adp1030/VLSI_Sine_Gen/report/dac_layout.png

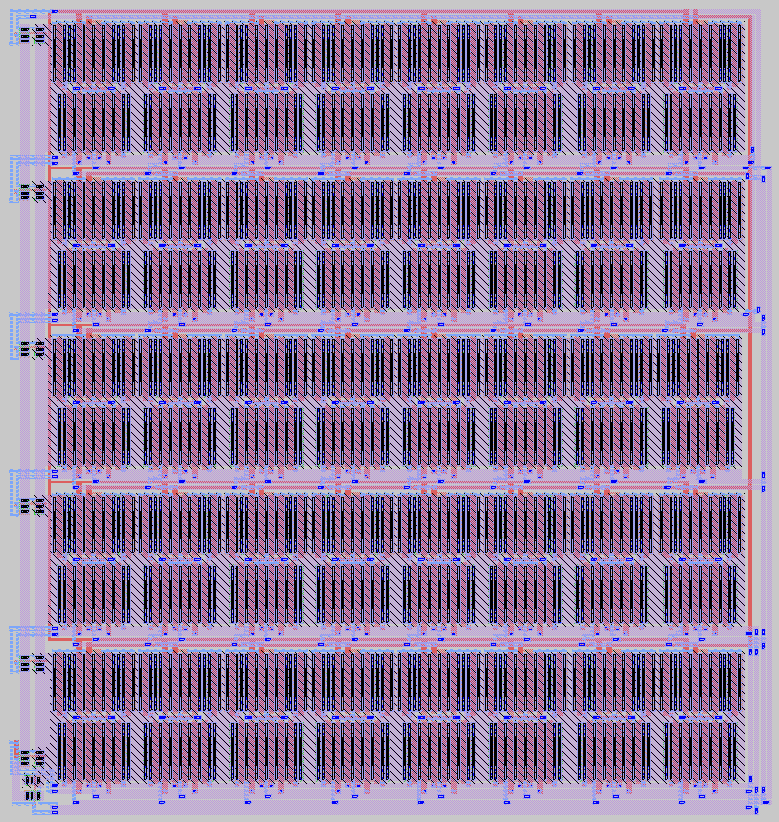
report/dac_layout.png
