adp1030/VLSI_Sine_Gen/report/dac_unit_layout.png

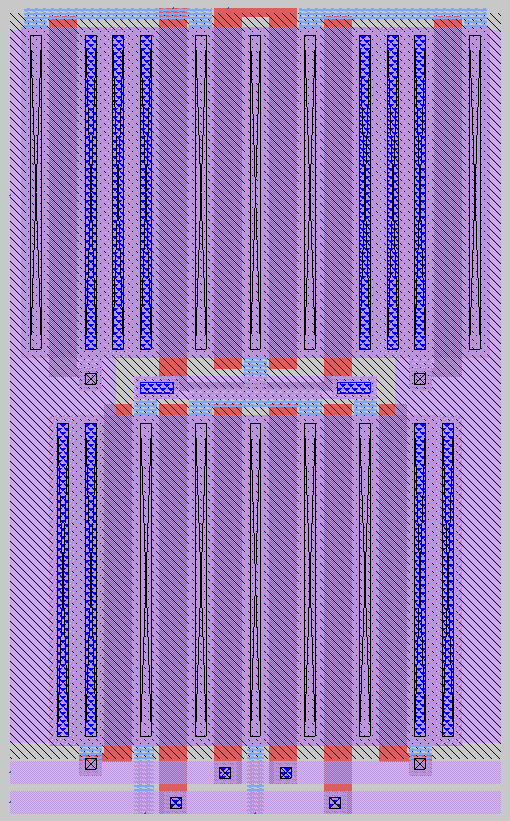
report/dac_unit_layout.png
