adp1030/VLSI_Sine_Gen/report/dac_unit_xschem.png

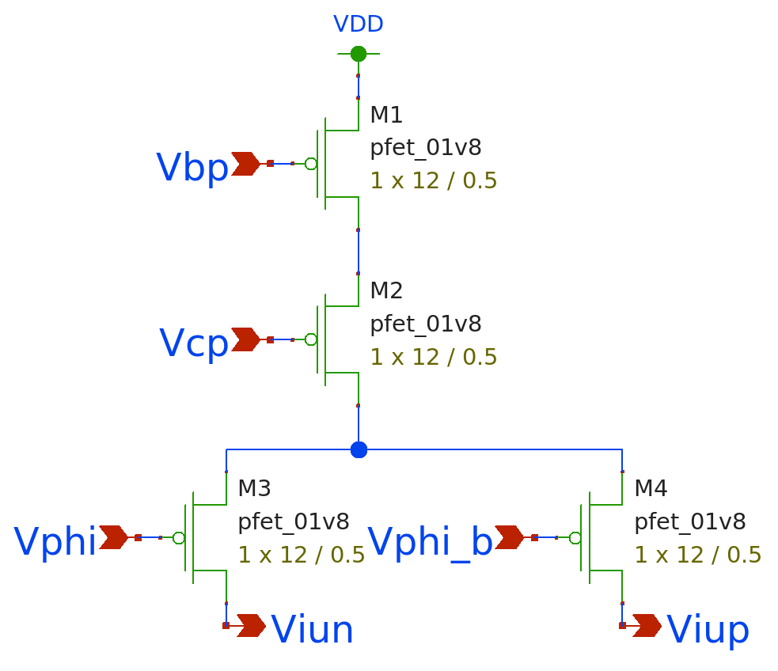
report/dac_unit_xschem.png
