adp1030/VLSI_Sine_Gen/report/dac_xschem.png

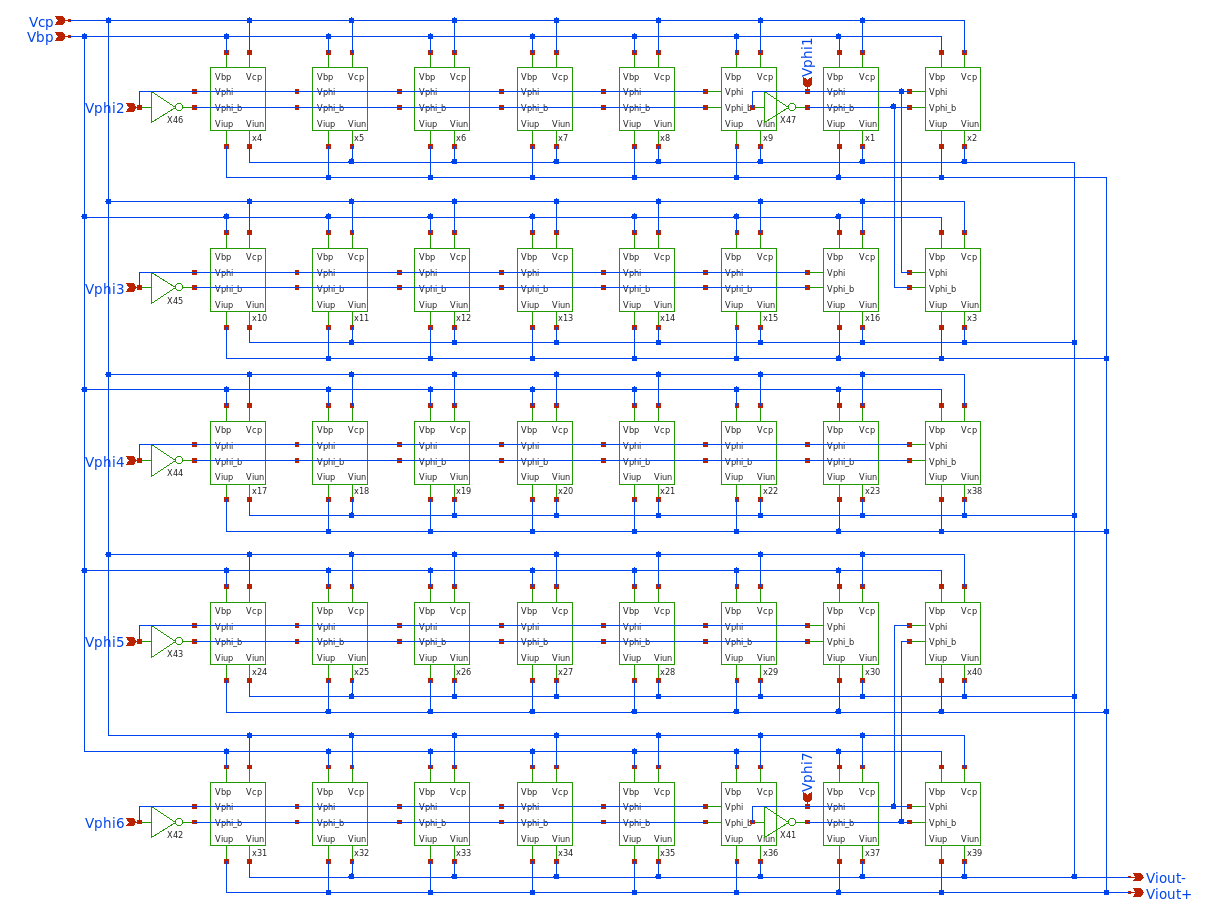
report/dac_xschem.png
