adp1030/VLSI_Sine_Gen/report/final_layout.png

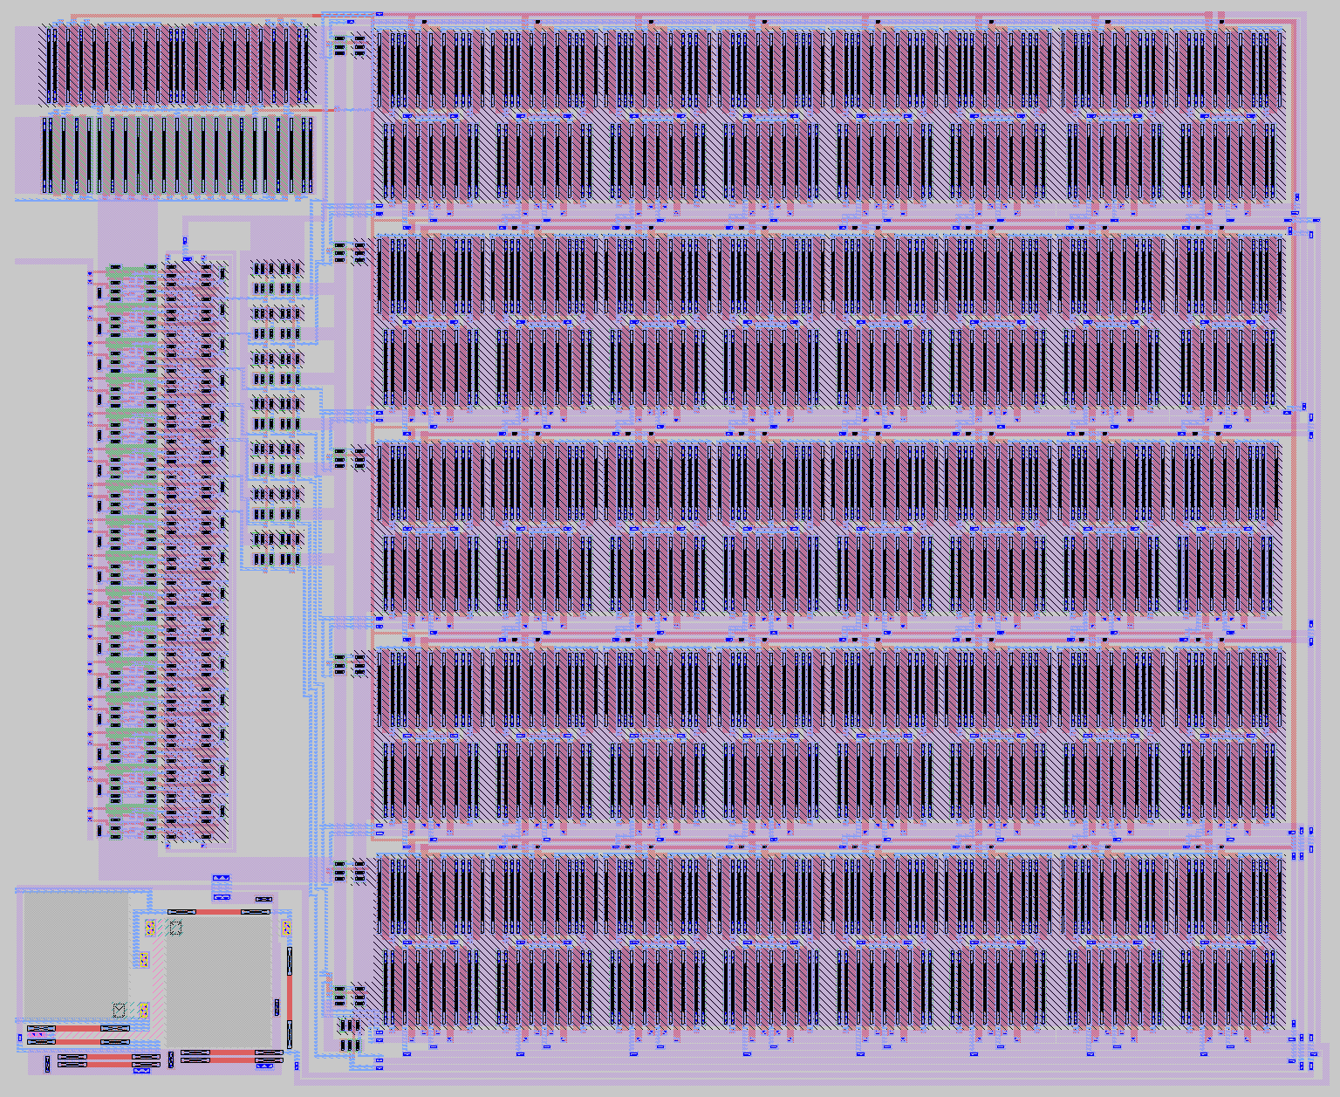
report/final_layout.png
