adp1030/VLSI_Sine_Gen/report/final_xschem.png

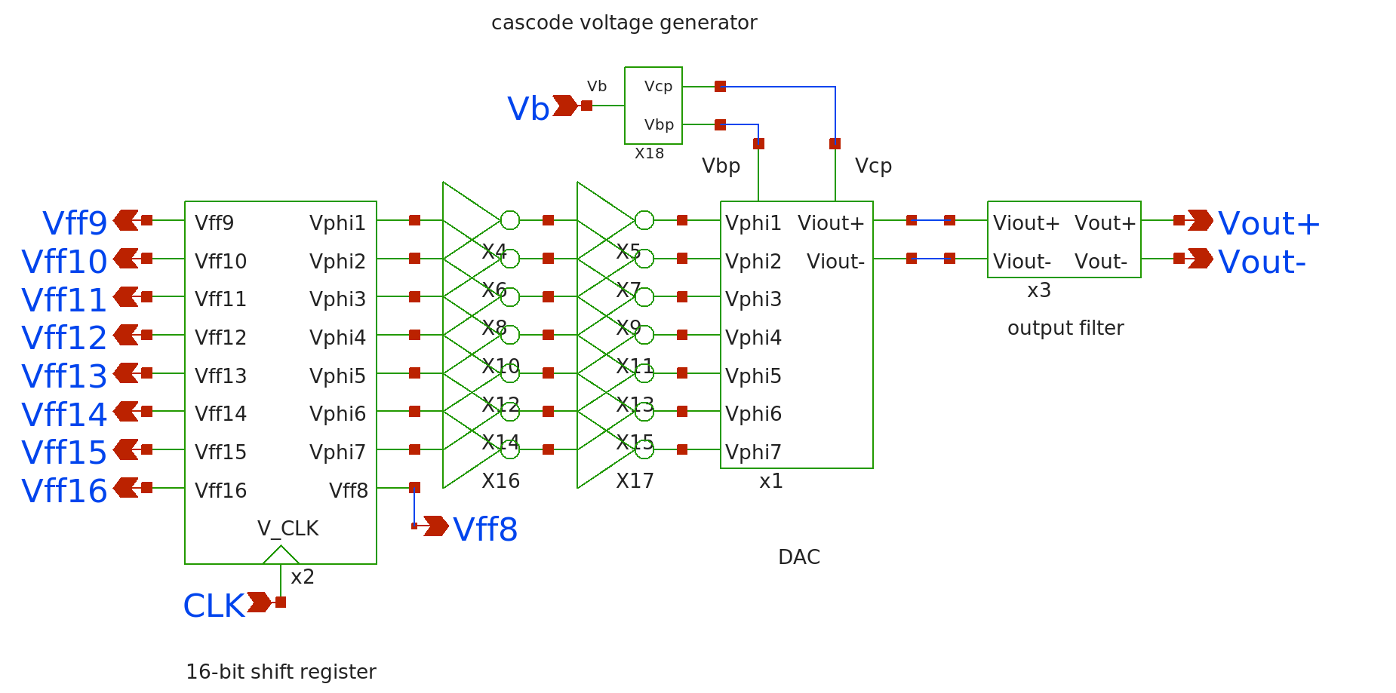
report/final_xschem.png
