adp1030/VLSI_Sine_Gen/report/register_layout.png

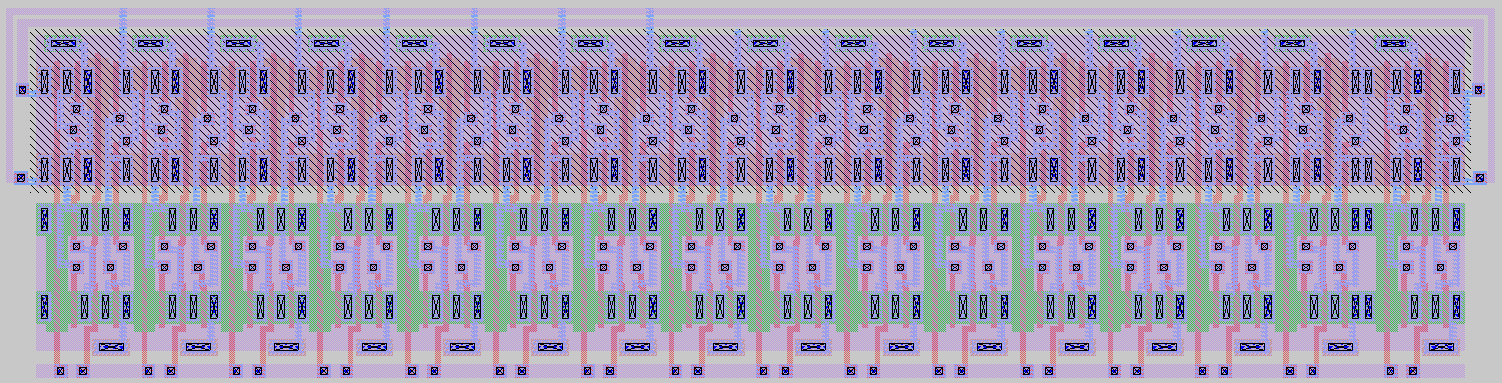
report/register_layout.png
