adp1030/VLSI_Sine_Gen/report/shift_register_xschem.png

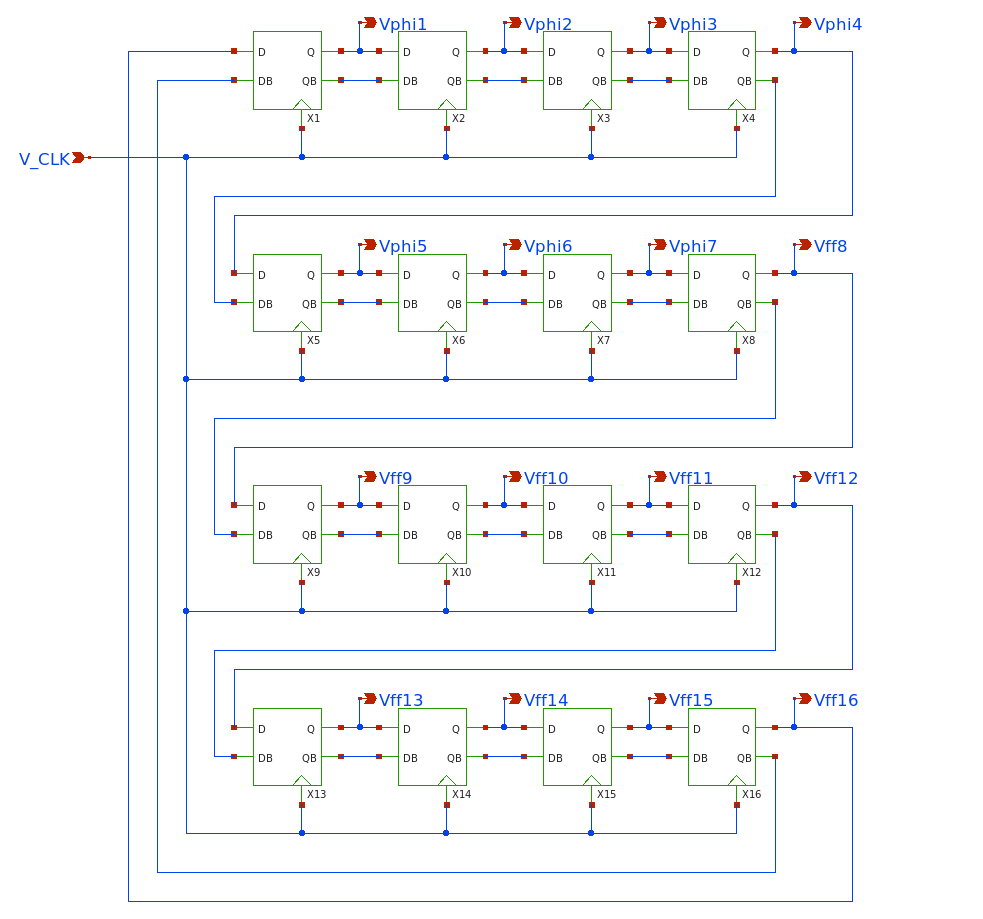
report/shift_register_xschem.png
