adp1030/VLSI_Sine_Gen/report/v_gen_layout.png

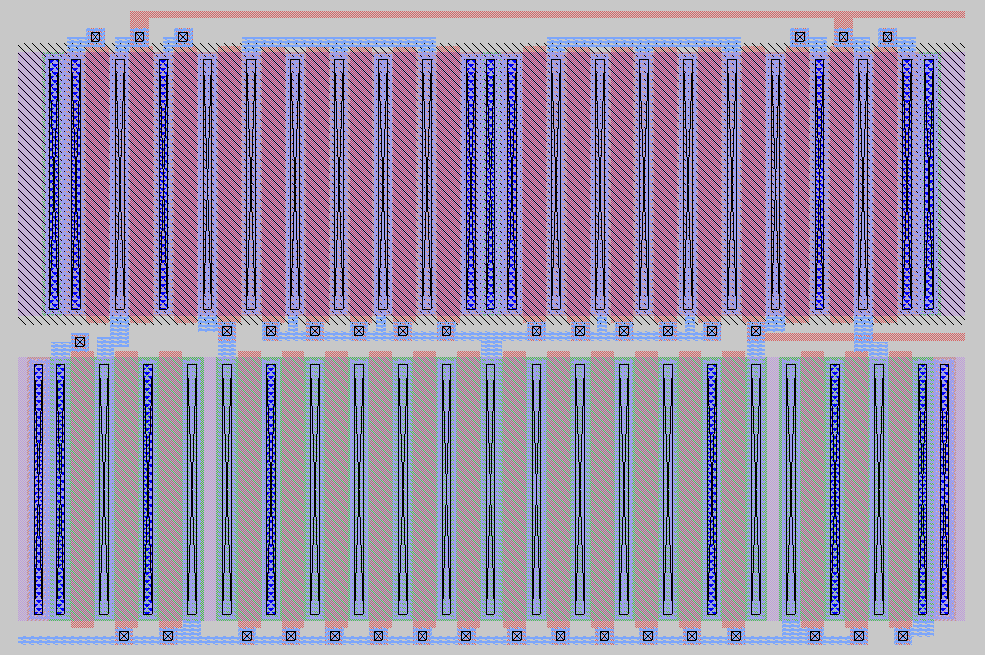
report/v_gen_layout.png
