adp1030/VLSI_Sine_Gen/report/v_gen_xschem.png

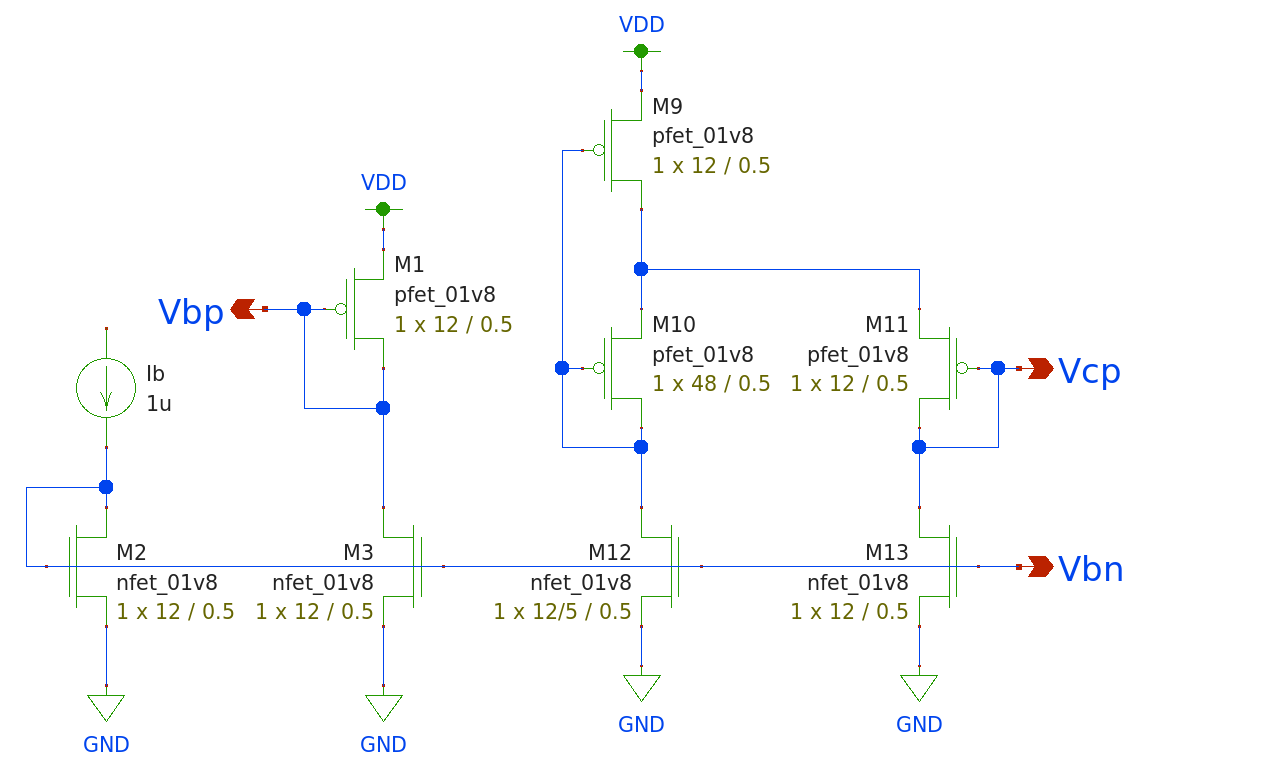
report/v_gen_xschem.png
