adp1030/VLSI_Sine_Gen/simulation/sim_data/plots/sin_wave_gen_vout_20ns_period.png

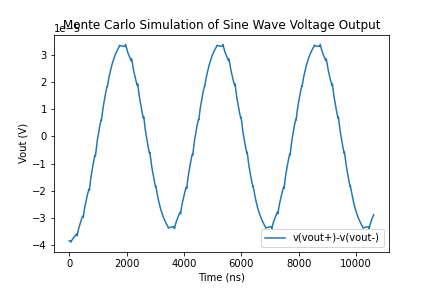
simulation/sim_data/plots/sin_wave_gen_vout_20ns_period.png
