adp1030/VLSI_Sine_Gen/layout/final_lds.spice

** sch_path: /home/madvlsi/VLSI_Sine_Gen/simulation/final_lds.sch
**.subckt final_lds Vb Vff9 Vff10 Vff11 Vff12 Vff13 Vff14 Vff15 Vff16 CLK Vff8 Vout+ Vout-
*.ipin Vb
*.opin Vff9
*.opin Vff10
*.opin Vff11
*.opin Vff12
*.opin Vff13
*.opin Vff14
*.opin Vff15
*.opin Vff16
*.ipin CLK
*.opin Vff8
*.opin Vout+
*.opin Vout-
x2 Vff10 Vff11 Vff12 Vff13 Vff14 Vff16 Vff15 Vff9 net5 net6 net7 net8 net9 net10 net11 Vff8 CLK
+ register_lauren
X18 net4 net3 Vb v_gen_lds
x1 net12 net13 net14 net15 net16 net17 net18 net1 net2 net3 net4 dac
X4 net5 net19 inverter
X5 net19 net12 inverter
X6 net6 net20 inverter
X7 net20 net13 inverter
X8 net7 net21 inverter
X9 net21 net14 inverter
X10 net8 net22 inverter
X11 net22 net15 inverter
X12 net9 net23 inverter
X13 net23 net16 inverter
X14 net10 net24 inverter
X15 net24 net17 inverter
X16 net11 net25 inverter
X17 net25 net18 inverter
x3 net1 net2 Vout+ Vout- filter_lvs
**.ends

* expanding   symbol:  ./shift_register/register_lauren.sym # of pins=17
** sym_path: /home/madvlsi/VLSI_Sine_Gen/simulation/shift_register/register_lauren.sym
** sch_path: /home/madvlsi/VLSI_Sine_Gen/simulation/shift_register/register_lauren.sch
.subckt register_lauren Vff10 Vff11 Vff12 Vff13 Vff14 Vff16 Vff15 Vff9 Vphi1 Vphi2 Vphi3 Vphi4 Vphi5
+ Vphi6 Vphi7 Vff8 V_CLK
*.opin Vphi1
*.opin Vphi2
*.opin Vphi3
*.opin Vphi4
*.opin Vphi5
*.opin Vphi6
*.opin Vphi7
*.opin Vff8
*.opin Vff9
*.opin Vff10
*.opin Vff11
*.opin Vff12
*.opin Vff13
*.opin Vff14
*.opin Vff15
*.opin Vff16
*.ipin V_CLK
X1 Vff16 net4 Vphi1 net5 V_CLK csrl_dff3_lds
X2 Vphi1 net5 Vphi2 net6 V_CLK csrl_dff3_lds
X3 Vphi2 net6 Vphi3 net7 V_CLK csrl_dff3_lds
X4 Vphi3 net7 Vphi4 net1 V_CLK csrl_dff3_lds
X5 Vphi4 net1 Vphi5 net10 V_CLK csrl_dff3_lds
X6 Vphi5 net10 Vphi6 net9 V_CLK csrl_dff3_lds
X7 Vphi6 net9 Vphi7 net8 V_CLK csrl_dff3_lds
X8 Vphi7 net8 Vff8 net3 V_CLK csrl_dff3_lds
X9 Vff8 net3 Vff9 net11 V_CLK csrl_dff3_lds
X10 Vff9 net11 Vff10 net12 V_CLK csrl_dff3_lds
X11 Vff10 net12 Vff11 net13 V_CLK csrl_dff3_lds
X12 Vff11 net13 Vff12 net2 V_CLK csrl_dff3_lds
X13 Vff12 net2 Vff13 net16 V_CLK csrl_dff3_lds
X14 Vff13 net16 Vff14 net15 V_CLK csrl_dff3_lds
X15 Vff14 net15 Vff15 net14 V_CLK csrl_dff3_lds
X16 Vff15 net14 Vff16 net4 V_CLK csrl_dff3_lds
.ends


* expanding   symbol:  /home/madvlsi/VLSI_Sine_Gen/simulation/dac/v_gen_lds.sym # of pins=3
** sym_path: /home/madvlsi/VLSI_Sine_Gen/simulation/dac/v_gen_lds.sym
** sch_path: /home/madvlsi/VLSI_Sine_Gen/simulation/dac/v_gen_lds.sch
.subckt v_gen_lds Vcp Vbp Vb
*.opin Vcp
*.opin Vbp
*.ipin Vb
XM25 net1 Vcp Vcp VDD sky130_fd_pr__pfet_01v8 L=0.5 W=6 nf=1 ad='int((nf+1)/2) * W/nf * 0.29' as='int((nf+2)/2) * W/nf * 0.29'
+ pd='2*int((nf+1)/2) * (W/nf + 0.29)' ps='2*int((nf+2)/2) * (W/nf + 0.29)' nrd='0.29 / W' nrs='0.29 / W'
+ sa=0 sb=0 sd=0 mult=1 m=1
XM26 Vcp Vb GND GND sky130_fd_pr__nfet_01v8 L=0.5 W=6 nf=1 ad='int((nf+1)/2) * W/nf * 0.29' as='int((nf+2)/2) * W/nf * 0.29'
+ pd='2*int((nf+1)/2) * (W/nf + 0.29)' ps='2*int((nf+2)/2) * (W/nf + 0.29)' nrd='0.29 / W' nrs='0.29 / W'
+ sa=0 sb=0 sd=0 mult=1 m=1
XM27 net2 net2 net1 VDD sky130_fd_pr__pfet_01v8 L=0.5 W=6 nf=1 ad='int((nf+1)/2) * W/nf * 0.29' as='int((nf+2)/2) * W/nf * 0.29'
+ pd='2*int((nf+1)/2) * (W/nf + 0.29)' ps='2*int((nf+2)/2) * (W/nf + 0.29)' nrd='0.29 / W' nrs='0.29 / W'
+ sa=0 sb=0 sd=0 mult=1 m=1
XM28 GND Vb net3 GND sky130_fd_pr__nfet_01v8 L=0.5 W=6 nf=1 ad='int((nf+1)/2) * W/nf * 0.29' as='int((nf+2)/2) * W/nf * 0.29'
+ pd='2*int((nf+1)/2) * (W/nf + 0.29)' ps='2*int((nf+2)/2) * (W/nf + 0.29)' nrd='0.29 / W' nrs='0.29 / W'
+ sa=0 sb=0 sd=0 mult=1 m=1
XM41 net1 net2 net2 VDD sky130_fd_pr__pfet_01v8 L=0.5 W=6 nf=1 ad='int((nf+1)/2) * W/nf * 0.29' as='int((nf+2)/2) * W/nf * 0.29'
+ pd='2*int((nf+1)/2) * (W/nf + 0.29)' ps='2*int((nf+2)/2) * (W/nf + 0.29)' nrd='0.29 / W' nrs='0.29 / W'
+ sa=0 sb=0 sd=0 mult=1 m=1
XM42 net3 Vb net4 GND sky130_fd_pr__nfet_01v8 L=0.5 W=6 nf=1 ad='int((nf+1)/2) * W/nf * 0.29' as='int((nf+2)/2) * W/nf * 0.29'
+ pd='2*int((nf+1)/2) * (W/nf + 0.29)' ps='2*int((nf+2)/2) * (W/nf + 0.29)' nrd='0.29 / W' nrs='0.29 / W'
+ sa=0 sb=0 sd=0 mult=1 m=1
XM43 net2 net2 net1 VDD sky130_fd_pr__pfet_01v8 L=0.5 W=6 nf=1 ad='int((nf+1)/2) * W/nf * 0.29' as='int((nf+2)/2) * W/nf * 0.29'
+ pd='2*int((nf+1)/2) * (W/nf + 0.29)' ps='2*int((nf+2)/2) * (W/nf + 0.29)' nrd='0.29 / W' nrs='0.29 / W'
+ sa=0 sb=0 sd=0 mult=1 m=1
XM44 net4 Vb net5 GND sky130_fd_pr__nfet_01v8 L=0.5 W=6 nf=1 ad='int((nf+1)/2) * W/nf * 0.29' as='int((nf+2)/2) * W/nf * 0.29'
+ pd='2*int((nf+1)/2) * (W/nf + 0.29)' ps='2*int((nf+2)/2) * (W/nf + 0.29)' nrd='0.29 / W' nrs='0.29 / W'
+ sa=0 sb=0 sd=0 mult=1 m=1
XM45 net1 net2 net2 VDD sky130_fd_pr__pfet_01v8 L=0.5 W=6 nf=1 ad='int((nf+1)/2) * W/nf * 0.29' as='int((nf+2)/2) * W/nf * 0.29'
+ pd='2*int((nf+1)/2) * (W/nf + 0.29)' ps='2*int((nf+2)/2) * (W/nf + 0.29)' nrd='0.29 / W' nrs='0.29 / W'
+ sa=0 sb=0 sd=0 mult=1 m=1
XM46 net5 Vb net6 GND sky130_fd_pr__nfet_01v8 L=0.5 W=6 nf=1 ad='int((nf+1)/2) * W/nf * 0.29' as='int((nf+2)/2) * W/nf * 0.29'
+ pd='2*int((nf+1)/2) * (W/nf + 0.29)' ps='2*int((nf+2)/2) * (W/nf + 0.29)' nrd='0.29 / W' nrs='0.29 / W'
+ sa=0 sb=0 sd=0 mult=1 m=1
XM47 VDD net2 net1 VDD sky130_fd_pr__pfet_01v8 L=0.5 W=6 nf=1 ad='int((nf+1)/2) * W/nf * 0.29' as='int((nf+2)/2) * W/nf * 0.29'
+ pd='2*int((nf+1)/2) * (W/nf + 0.29)' ps='2*int((nf+2)/2) * (W/nf + 0.29)' nrd='0.29 / W' nrs='0.29 / W'
+ sa=0 sb=0 sd=0 mult=1 m=1
XM48 net6 Vb net2 GND sky130_fd_pr__nfet_01v8 L=0.5 W=6 nf=1 ad='int((nf+1)/2) * W/nf * 0.29' as='int((nf+2)/2) * W/nf * 0.29'
+ pd='2*int((nf+1)/2) * (W/nf + 0.29)' ps='2*int((nf+2)/2) * (W/nf + 0.29)' nrd='0.29 / W' nrs='0.29 / W'
+ sa=0 sb=0 sd=0 mult=1 m=1
XM54 VDD Vbp Vbp VDD sky130_fd_pr__pfet_01v8 L=0.5 W=6 nf=1 ad='int((nf+1)/2) * W/nf * 0.29' as='int((nf+2)/2) * W/nf * 0.29'
+ pd='2*int((nf+1)/2) * (W/nf + 0.29)' ps='2*int((nf+2)/2) * (W/nf + 0.29)' nrd='0.29 / W' nrs='0.29 / W'
+ sa=0 sb=0 sd=0 mult=1 m=1
XM1 Vbp Vb GND GND sky130_fd_pr__nfet_01v8 L=0.5 W=6 nf=1 ad='int((nf+1)/2) * W/nf * 0.29' as='int((nf+2)/2) * W/nf * 0.29'
+ pd='2*int((nf+1)/2) * (W/nf + 0.29)' ps='2*int((nf+2)/2) * (W/nf + 0.29)' nrd='0.29 / W' nrs='0.29 / W'
+ sa=0 sb=0 sd=0 mult=1 m=1
XM2 Vb Vb GND GND sky130_fd_pr__nfet_01v8 L=0.5 W=6 nf=1 ad='int((nf+1)/2) * W/nf * 0.29' as='int((nf+2)/2) * W/nf * 0.29'
+ pd='2*int((nf+1)/2) * (W/nf + 0.29)' ps='2*int((nf+2)/2) * (W/nf + 0.29)' nrd='0.29 / W' nrs='0.29 / W'
+ sa=0 sb=0 sd=0 mult=1 m=1
XM3 Vcp VDD VDD VDD sky130_fd_pr__pfet_01v8 L=0.5 W=6 nf=1 ad='int((nf+1)/2) * W/nf * 0.29' as='int((nf+2)/2) * W/nf * 0.29'
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
+ sa=0 sb=0 sd=0 mult=1 m=1
XM4 Vbp GND GND GND sky130_fd_pr__nfet_01v8 L=0.5 W=6 nf=1 ad='int((nf+1)/2) * W/nf * 0.29' as='int((nf+2)/2) * W/nf * 0.29'
+ pd='2*int((nf+1)/2) * (W/nf + 0.29)' ps='2*int((nf+2)/2) * (W/nf + 0.29)' nrd='0.29 / W' nrs='0.29 / W'
+ sa=0 sb=0 sd=0 mult=1 m=1
XM5 Vbp VDD VDD VDD sky130_fd_pr__pfet_01v8 L=0.5 W=6 nf=1 ad='int((nf+1)/2) * W/nf * 0.29' as='int((nf+2)/2) * W/nf * 0.29'
+ pd='2*int((nf+1)/2) * (W/nf + 0.29)' ps='2*int((nf+2)/2) * (W/nf + 0.29)' nrd='0.29 / W' nrs='0.29 / W'
+ sa=0 sb=0 sd=0 mult=1 m=1
XM6 GND GND Vbp GND sky130_fd_pr__nfet_01v8 L=0.5 W=6 nf=1 ad='int((nf+1)/2) * W/nf * 0.29' as='int((nf+2)/2) * W/nf * 0.29'
+ pd='2*int((nf+1)/2) * (W/nf + 0.29)' ps='2*int((nf+2)/2) * (W/nf + 0.29)' nrd='0.29 / W' nrs='0.29 / W'
+ sa=0 sb=0 sd=0 mult=1 m=1
XM7 Vbp VDD VDD VDD sky130_fd_pr__pfet_01v8 L=0.5 W=6 nf=1 ad='int((nf+1)/2) * W/nf * 0.29' as='int((nf+2)/2) * W/nf * 0.29'
+ pd='2*int((nf+1)/2) * (W/nf + 0.29)' ps='2*int((nf+2)/2) * (W/nf + 0.29)' nrd='0.29 / W' nrs='0.29 / W'
+ sa=0 sb=0 sd=0 mult=1 m=1
.ends


* expanding   symbol:  ./dac/dac.sym # of pins=11
** sym_path: /home/madvlsi/VLSI_Sine_Gen/simulation/dac/dac.sym
** sch_path: /home/madvlsi/VLSI_Sine_Gen/simulation/dac/dac.sch
.subckt dac Vphi1 Vphi2 Vphi3 Vphi4 Vphi5 Vphi6 Vphi7 Viout+ Viout- Vbp Vcp
*.ipin Vphi1
*.ipin Vphi2
*.ipin Vphi3
*.ipin Vphi4
*.ipin Vphi5
*.ipin Vphi6
*.ipin Vphi7
*.opin Viout+
*.opin Viout-
*.ipin Vcp
*.ipin Vbp
x1 Vbp Vcp Viout+ Viout- Vphi1 net1 dac_unit_lds2
x2 Vbp Vcp Viout+ Viout- Vphi1 net1 dac_unit_lds2
x3 Vbp Vcp Viout+ Viout- Vphi1 net1 dac_unit_lds2
x4 Vbp Vcp Viout+ Viout- Vphi2 net2 dac_unit_lds2
x5 Vbp Vcp Viout+ Viout- Vphi2 net2 dac_unit_lds2
x6 Vbp Vcp Viout+ Viout- Vphi2 net2 dac_unit_lds2
x7 Vbp Vcp Viout+ Viout- Vphi2 net2 dac_unit_lds2
x8 Vbp Vcp Viout+ Viout- Vphi2 net2 dac_unit_lds2
x9 Vbp Vcp Viout+ Viout- Vphi2 net2 dac_unit_lds2
x10 Vbp Vcp Viout+ Viout- Vphi3 net3 dac_unit_lds2
x11 Vbp Vcp Viout+ Viout- Vphi3 net3 dac_unit_lds2
x12 Vbp Vcp Viout+ Viout- Vphi3 net3 dac_unit_lds2
x13 Vbp Vcp Viout+ Viout- Vphi3 net3 dac_unit_lds2
x14 Vbp Vcp Viout+ Viout- Vphi3 net3 dac_unit_lds2
x15 Vbp Vcp Viout+ Viout- Vphi3 net3 dac_unit_lds2
x16 Vbp Vcp Viout+ Viout- Vphi3 net3 dac_unit_lds2
x17 Vbp Vcp Viout+ Viout- Vphi4 net4 dac_unit_lds2
x18 Vbp Vcp Viout+ Viout- Vphi4 net4 dac_unit_lds2
x19 Vbp Vcp Viout+ Viout- Vphi4 net4 dac_unit_lds2
x20 Vbp Vcp Viout+ Viout- Vphi4 net4 dac_unit_lds2
x21 Vbp Vcp Viout+ Viout- Vphi4 net4 dac_unit_lds2
x22 Vbp Vcp Viout+ Viout- Vphi4 net4 dac_unit_lds2
x23 Vbp Vcp Viout+ Viout- Vphi4 net4 dac_unit_lds2
x24 Vbp Vcp Viout+ Viout- Vphi5 net5 dac_unit_lds2
x25 Vbp Vcp Viout+ Viout- Vphi5 net5 dac_unit_lds2
x26 Vbp Vcp Viout+ Viout- Vphi5 net5 dac_unit_lds2
x27 Vbp Vcp Viout+ Viout- Vphi5 net5 dac_unit_lds2
x28 Vbp Vcp Viout+ Viout- Vphi5 net5 dac_unit_lds2
x29 Vbp Vcp Viout+ Viout- Vphi5 net5 dac_unit_lds2
x30 Vbp Vcp Viout+ Viout- Vphi5 net5 dac_unit_lds2
x31 Vbp Vcp Viout+ Viout- Vphi6 net6 dac_unit_lds2
x32 Vbp Vcp Viout+ Viout- Vphi6 net6 dac_unit_lds2
x33 Vbp Vcp Viout+ Viout- Vphi6 net6 dac_unit_lds2
x34 Vbp Vcp Viout+ Viout- Vphi6 net6 dac_unit_lds2
x35 Vbp Vcp Viout+ Viout- Vphi6 net6 dac_unit_lds2
x36 Vbp Vcp Viout+ Viout- Vphi6 net6 dac_unit_lds2
x38 Vbp Vcp Viout+ Viout- Vphi4 net4 dac_unit_lds2
x37 Vbp Vcp Viout+ Viout- Vphi7 net7 dac_unit_lds2
x39 Vbp Vcp Viout+ Viout- Vphi7 net7 dac_unit_lds2
x40 Vbp Vcp Viout+ Viout- Vphi7 net7 dac_unit_lds2
X41 Vphi7 net7 inverter
X42 Vphi6 net6 inverter
X43 Vphi5 net5 inverter
X44 Vphi4 net4 inverter
X45 Vphi3 net3 inverter
X46 Vphi2 net2 inverter
X47 Vphi1 net1 inverter
.ends


* expanding   symbol:  /home/madvlsi/VLSI_Sine_Gen/simulation/dac/inverter.sym # of pins=2
** sym_path: /home/madvlsi/VLSI_Sine_Gen/simulation/dac/inverter.sym
** sch_path: /home/madvlsi/VLSI_Sine_Gen/simulation/dac/inverter.sch
.subckt inverter A Y
*.ipin A
*.opin Y
XM1 Y A VDD VDD sky130_fd_pr__pfet_01v8 L=0.15 W=1 nf=1 ad='int((nf+1)/2) * W/nf * 0.29' as='int((nf+2)/2) * W/nf * 0.29'
+ pd='2*int((nf+1)/2) * (W/nf + 0.29)' ps='2*int((nf+2)/2) * (W/nf + 0.29)' nrd='0.29 / W' nrs='0.29 / W'
+ sa=0 sb=0 sd=0 mult=1 m=1
XM2 Y A GND GND sky130_fd_pr__nfet_01v8 L=0.15 W=1 nf=1 ad='int((nf+1)/2) * W/nf * 0.29' as='int((nf+2)/2) * W/nf * 0.29'
+ pd='2*int((nf+1)/2) * (W/nf + 0.29)' ps='2*int((nf+2)/2) * (W/nf + 0.29)' nrd='0.29 / W' nrs='0.29 / W'
+ sa=0 sb=0 sd=0 mult=1 m=1
.ends


* expanding   symbol:  /home/madvlsi/VLSI_Sine_Gen/simulation/filter/filter_lvs.sym # of pins=4
** sym_path: /home/madvlsi/VLSI_Sine_Gen/simulation/filter/filter_lvs.sym
** sch_path: /home/madvlsi/VLSI_Sine_Gen/simulation/filter/filter_lvs.sch
.subckt filter_lvs Viout+ Viout- Vout+ Vout-
*.opin Vout+
*.opin Vout-
*.ipin Viout+
*.ipin Viout-
XC3 Vout+ Vout- sky130_fd_pr__cap_mim_m3_1 W=8 L=10 MF=1 m=1
XC4 net1 net2 sky130_fd_pr__cap_mim_m3_1 W=8 L=10 MF=1 m=1
XR7 net2 Vout- GND sky130_fd_pr__res_xhigh_po W=1 L=10 mult=1 m=1
XR8 Viout- net2 GND sky130_fd_pr__res_xhigh_po W=1 L=10 mult=1 m=1
XR9 Vout+ net1 GND sky130_fd_pr__res_xhigh_po W=1 L=10 mult=1 m=1
XR10 net1 Viout+ GND sky130_fd_pr__res_xhigh_po W=1 L=10 mult=1 m=1
XR11 GND Viout- GND sky130_fd_pr__res_xhigh_po W=0.35 L=7 mult=1 m=1
XR12 Viout+ GND GND sky130_fd_pr__res_xhigh_po W=0.35 L=7 mult=1 m=1
.ends


* expanding   symbol:
*+  /home/madvlsi/VLSI_Sine_Gen/simulation/shift_register/lauren_mp2_files/csrl_dff3_lds.sym # of pins=5
** sym_path:
*+ /home/madvlsi/VLSI_Sine_Gen/simulation/shift_register/lauren_mp2_files/csrl_dff3_lds.sym
** sch_path:
*+ /home/madvlsi/VLSI_Sine_Gen/simulation/shift_register/lauren_mp2_files/csrl_dff3_lds.sch
.subckt csrl_dff3_lds D DB Q QB CLK
*.ipin D
*.ipin DB
*.ipin CLK
*.opin Q
*.opin QB
XM1 net1 CLK D VDD sky130_fd_pr__pfet_01v8 L=0.15 W=1 nf=1 ad='int((nf+1)/2) * W/nf * 0.29' as='int((nf+2)/2) * W/nf * 0.29'
+ pd='2*int((nf+1)/2) * (W/nf + 0.29)' ps='2*int((nf+2)/2) * (W/nf + 0.29)' nrd='0.29 / W' nrs='0.29 / W'
+ sa=0 sb=0 sd=0 mult=1 m=1
XM2 net3 CLK DB VDD sky130_fd_pr__pfet_01v8 L=0.15 W=1 nf=1 ad='int((nf+1)/2) * W/nf * 0.29' as='int((nf+2)/2) * W/nf * 0.29'
+ pd='2*int((nf+1)/2) * (W/nf + 0.29)' ps='2*int((nf+2)/2) * (W/nf + 0.29)' nrd='0.29 / W' nrs='0.29 / W'
+ sa=0 sb=0 sd=0 mult=1 m=1
XM3 VDD net1 net3 VDD sky130_fd_pr__pfet_01v8 L=0.15 W=1 nf=1 ad='int((nf+1)/2) * W/nf * 0.29' as='int((nf+2)/2) * W/nf * 0.29'
+ pd='2*int((nf+1)/2) * (W/nf + 0.29)' ps='2*int((nf+2)/2) * (W/nf + 0.29)' nrd='0.29 / W' nrs='0.29 / W'
+ sa=0 sb=0 sd=0 mult=1 m=1
XM4 VDD net3 net1 VDD sky130_fd_pr__pfet_01v8 L=0.15 W=1 nf=1 ad='int((nf+1)/2) * W/nf * 0.29' as='int((nf+2)/2) * W/nf * 0.29'
+ pd='2*int((nf+1)/2) * (W/nf + 0.29)' ps='2*int((nf+2)/2) * (W/nf + 0.29)' nrd='0.29 / W' nrs='0.29 / W'
+ sa=0 sb=0 sd=0 mult=1 m=1
XM5 net4 net1 net3 GND sky130_fd_pr__nfet_01v8 L=0.15 W=1 nf=1 ad='int((nf+1)/2) * W/nf * 0.29' as='int((nf+2)/2) * W/nf * 0.29'
+ pd='2*int((nf+1)/2) * (W/nf + 0.29)' ps='2*int((nf+2)/2) * (W/nf + 0.29)' nrd='0.29 / W' nrs='0.29 / W'
+ sa=0 sb=0 sd=0 mult=1 m=1
XM6 net4 net3 net1 GND sky130_fd_pr__nfet_01v8 L=0.15 W=1 nf=1 ad='int((nf+1)/2) * W/nf * 0.29' as='int((nf+2)/2) * W/nf * 0.29'
+ pd='2*int((nf+1)/2) * (W/nf + 0.29)' ps='2*int((nf+2)/2) * (W/nf + 0.29)' nrd='0.29 / W' nrs='0.29 / W'
+ sa=0 sb=0 sd=0 mult=1 m=1
XM7 net1 CLK Q GND sky130_fd_pr__nfet_01v8 L=0.15 W=1 nf=1 ad='int((nf+1)/2) * W/nf * 0.29' as='int((nf+2)/2) * W/nf * 0.29'
+ pd='2*int((nf+1)/2) * (W/nf + 0.29)' ps='2*int((nf+2)/2) * (W/nf + 0.29)' nrd='0.29 / W' nrs='0.29 / W'
+ sa=0 sb=0 sd=0 mult=1 m=1
XM8 net3 CLK QB GND sky130_fd_pr__nfet_01v8 L=0.15 W=1 nf=1 ad='int((nf+1)/2) * W/nf * 0.29' as='int((nf+2)/2) * W/nf * 0.29'
+ pd='2*int((nf+1)/2) * (W/nf + 0.29)' ps='2*int((nf+2)/2) * (W/nf + 0.29)' nrd='0.29 / W' nrs='0.29 / W'
+ sa=0 sb=0 sd=0 mult=1 m=1
XM9 Q QB net2 VDD sky130_fd_pr__pfet_01v8 L=0.15 W=1 nf=1 ad='int((nf+1)/2) * W/nf * 0.29' as='int((nf+2)/2) * W/nf * 0.29'
+ pd='2*int((nf+1)/2) * (W/nf + 0.29)' ps='2*int((nf+2)/2) * (W/nf + 0.29)' nrd='0.29 / W' nrs='0.29 / W'
+ sa=0 sb=0 sd=0 mult=1 m=1
XM10 QB Q net2 VDD sky130_fd_pr__pfet_01v8 L=0.15 W=1 nf=1 ad='int((nf+1)/2) * W/nf * 0.29' as='int((nf+2)/2) * W/nf * 0.29'
+ pd='2*int((nf+1)/2) * (W/nf + 0.29)' ps='2*int((nf+2)/2) * (W/nf + 0.29)' nrd='0.29 / W' nrs='0.29 / W'
+ sa=0 sb=0 sd=0 mult=1 m=1
XM11 Q QB GND GND sky130_fd_pr__nfet_01v8 L=0.15 W=1 nf=1 ad='int((nf+1)/2) * W/nf * 0.29' as='int((nf+2)/2) * W/nf * 0.29'
+ pd='2*int((nf+1)/2) * (W/nf + 0.29)' ps='2*int((nf+2)/2) * (W/nf + 0.29)' nrd='0.29 / W' nrs='0.29 / W'
+ sa=0 sb=0 sd=0 mult=1 m=1
XM12 QB Q GND GND sky130_fd_pr__nfet_01v8 L=0.15 W=1 nf=1 ad='int((nf+1)/2) * W/nf * 0.29' as='int((nf+2)/2) * W/nf * 0.29'
+ pd='2*int((nf+1)/2) * (W/nf + 0.29)' ps='2*int((nf+2)/2) * (W/nf + 0.29)' nrd='0.29 / W' nrs='0.29 / W'
+ sa=0 sb=0 sd=0 mult=1 m=1
XM13 GND CLK net4 GND sky130_fd_pr__nfet_01v8 L=0.15 W=4 nf=1 ad='int((nf+1)/2) * W/nf * 0.29' as='int((nf+2)/2) * W/nf * 0.29'
+ pd='2*int((nf+1)/2) * (W/nf + 0.29)' ps='2*int((nf+2)/2) * (W/nf + 0.29)' nrd='0.29 / W' nrs='0.29 / W'
+ sa=0 sb=0 sd=0 mult=1 m=1
XM14 net2 CLK VDD VDD sky130_fd_pr__pfet_01v8 L=0.15 W=4 nf=1 ad='int((nf+1)/2) * W/nf * 0.29' as='int((nf+2)/2) * W/nf * 0.29'
+ pd='2*int((nf+1)/2) * (W/nf + 0.29)' ps='2*int((nf+2)/2) * (W/nf + 0.29)' nrd='0.29 / W' nrs='0.29 / W'
+ sa=0 sb=0 sd=0 mult=1 m=1
.ends


* expanding   symbol:  /home/madvlsi/VLSI_Sine_Gen/simulation/dac/dac_unit_lds2.sym # of pins=6
** sym_path: /home/madvlsi/VLSI_Sine_Gen/simulation/dac/dac_unit_lds2.sym
** sch_path: /home/madvlsi/VLSI_Sine_Gen/simulation/dac/dac_unit_lds2.sch
.subckt dac_unit_lds2 Vbp Vcp Viup Viun Vphi Vphi_b
*.ipin Vphi
*.ipin Vbp
*.ipin Vcp
*.opin Viun
*.opin Viup
*.ipin Vphi_b
XM1 net1 Vbp VDD VDD sky130_fd_pr__pfet_01v8 L=0.5 W=6 nf=1 ad='int((nf+1)/2) * W/nf * 0.29' as='int((nf+2)/2) * W/nf * 0.29'
+ pd='2*int((nf+1)/2) * (W/nf + 0.29)' ps='2*int((nf+2)/2) * (W/nf + 0.29)' nrd='0.29 / W' nrs='0.29 / W'
+ sa=0 sb=0 sd=0 mult=1 m=1
XM2 net2 Vcp net1 VDD sky130_fd_pr__pfet_01v8 L=0.5 W=6 nf=1 ad='int((nf+1)/2) * W/nf * 0.29' as='int((nf+2)/2) * W/nf * 0.29'
+ pd='2*int((nf+1)/2) * (W/nf + 0.29)' ps='2*int((nf+2)/2) * (W/nf + 0.29)' nrd='0.29 / W' nrs='0.29 / W'
+ sa=0 sb=0 sd=0 mult=1 m=1
XM3 net2 Vphi Viun VDD sky130_fd_pr__pfet_01v8 L=0.5 W=6 nf=1 ad='int((nf+1)/2) * W/nf * 0.29' as='int((nf+2)/2) * W/nf * 0.29'
+ pd='2*int((nf+1)/2) * (W/nf + 0.29)' ps='2*int((nf+2)/2) * (W/nf + 0.29)' nrd='0.29 / W' nrs='0.29 / W'
+ sa=0 sb=0 sd=0 mult=1 m=1
XM4 net2 Vphi_b Viup VDD sky130_fd_pr__pfet_01v8 L=0.5 W=6 nf=1 ad='int((nf+1)/2) * W/nf * 0.29' as='int((nf+2)/2) * W/nf * 0.29'
+ pd='2*int((nf+1)/2) * (W/nf + 0.29)' ps='2*int((nf+2)/2) * (W/nf + 0.29)' nrd='0.29 / W' nrs='0.29 / W'
+ sa=0 sb=0 sd=0 mult=1 m=1
XM5 net3 Vbp VDD VDD sky130_fd_pr__pfet_01v8 L=0.5 W=6 nf=1 ad='int((nf+1)/2) * W/nf * 0.29' as='int((nf+2)/2) * W/nf * 0.29'
+ pd='2*int((nf+1)/2) * (W/nf + 0.29)' ps='2*int((nf+2)/2) * (W/nf + 0.29)' nrd='0.29 / W' nrs='0.29 / W'
+ sa=0 sb=0 sd=0 mult=1 m=1
XM6 net2 Vcp net3 VDD sky130_fd_pr__pfet_01v8 L=0.5 W=6 nf=1 ad='int((nf+1)/2) * W/nf * 0.29' as='int((nf+2)/2) * W/nf * 0.29'
+ pd='2*int((nf+1)/2) * (W/nf + 0.29)' ps='2*int((nf+2)/2) * (W/nf + 0.29)' nrd='0.29 / W' nrs='0.29 / W'
+ sa=0 sb=0 sd=0 mult=1 m=1
XM7 net2 Vphi Viun VDD sky130_fd_pr__pfet_01v8 L=0.5 W=6 nf=1 ad='int((nf+1)/2) * W/nf * 0.29' as='int((nf+2)/2) * W/nf * 0.29'
+ pd='2*int((nf+1)/2) * (W/nf + 0.29)' ps='2*int((nf+2)/2) * (W/nf + 0.29)' nrd='0.29 / W' nrs='0.29 / W'
+ sa=0 sb=0 sd=0 mult=1 m=1
XM8 net2 Vphi_b Viup VDD sky130_fd_pr__pfet_01v8 L=0.5 W=6 nf=1 ad='int((nf+1)/2) * W/nf * 0.29' as='int((nf+2)/2) * W/nf * 0.29'
+ pd='2*int((nf+1)/2) * (W/nf + 0.29)' ps='2*int((nf+2)/2) * (W/nf + 0.29)' nrd='0.29 / W' nrs='0.29 / W'
+ sa=0 sb=0 sd=0 mult=1 m=1
XM9 VDD VDD net1 VDD sky130_fd_pr__pfet_01v8 L=0.5 W=6 nf=1 ad='int((nf+1)/2) * W/nf * 0.29' as='int((nf+2)/2) * W/nf * 0.29'
+ pd='2*int((nf+1)/2) * (W/nf + 0.29)' ps='2*int((nf+2)/2) * (W/nf + 0.29)' nrd='0.29 / W' nrs='0.29 / W'
+ sa=0 sb=0 sd=0 mult=1 m=1
XM10 net3 VDD VDD VDD sky130_fd_pr__pfet_01v8 L=0.5 W=6 nf=1 ad='int((nf+1)/2) * W/nf * 0.29' as='int((nf+2)/2) * W/nf * 0.29'
+ pd='2*int((nf+1)/2) * (W/nf + 0.29)' ps='2*int((nf+2)/2) * (W/nf + 0.29)' nrd='0.29 / W' nrs='0.29 / W'
+ sa=0 sb=0 sd=0 mult=1 m=1
XM11 VDD VDD Viup VDD sky130_fd_pr__pfet_01v8 L=0.5 W=6 nf=1 ad='int((nf+1)/2) * W/nf * 0.29' as='int((nf+2)/2) * W/nf * 0.29'
+ pd='2*int((nf+1)/2) * (W/nf + 0.29)' ps='2*int((nf+2)/2) * (W/nf + 0.29)' nrd='0.29 / W' nrs='0.29 / W'
+ sa=0 sb=0 sd=0 mult=1 m=1
XM12 VDD VDD Viup VDD sky130_fd_pr__pfet_01v8 L=0.5 W=6 nf=1 ad='int((nf+1)/2) * W/nf * 0.29' as='int((nf+2)/2) * W/nf * 0.29'
+ pd='2*int((nf+1)/2) * (W/nf + 0.29)' ps='2*int((nf+2)/2) * (W/nf + 0.29)' nrd='0.29 / W' nrs='0.29 / W'
+ sa=0 sb=0 sd=0 mult=1 m=1
.ends

.GLOBAL GND
.GLOBAL VDD
.end
