adp1030/VLSI_Sine_Gen/(commit log)

2023-12-01 adding initial shift register simulations
    [csrl_dff3.sch, csrl_dff3_lds.sch, csrl_dff3_lds_tran.sch, csrl_dff3_tran.sch, d_flipflop.sch, d_flipflop_LDS.sch, d_flipflop_LDS_Final.sch, d_flipflop_LDS_v2.sch]
2023-12-01 adding working shift register
    [shift_register_tran_working.sch]
2023-12-01 added yet-to-be simulated dac
    [cascode_v_gen.sch, dac.sch, dac_unit.sch, inverter.sch, v_gen_lds.sch]
2023-12-01 changing ff paths in shift register
    [shift_register_tran_working.sch]
2023-12-02 added working dac
    [dac.sch, dac_unit.sch]
2023-12-05 added unspecced output filter load
    [dac.sch]
2023-12-10 added working higher level simulations
    [dac.sch, dac_tran.sch, inverter.sch, register_dac_tran_lauren.sch, register_lauren.sch, shift_register_tran_4bit_lauren.sch, shift_register_tran_lauren.sch]
2023-12-11 added not-working switch cap filters
    [dac.sch, dac_tran (copy).sch, filter.sch, filter_test1.sch, filter_tran.sch, register_dac_mc_lauren.sch]
2023-12-11 added working mc and testing switch cap filters
    [filter.sch, filter_switch_cap.sch, filter_switch_cap_tran.sch, filter_test1.sch, filter_tran.sch, register_dac_mc_lauren.sch]
2023-12-11 added better rc filter and sim data
    [filter.sch, register_dac_mc_lauren.sch]
2023-12-11 changing symbol paths
    [register_dac_mc_lauren.sch, register_dac_tran_lauren.sch]
2023-12-12 add initial dac lds
    [dac_unit_lds.sch, dac_unit_lds_v2.sch, register_dac_tran_andrew.sch]
2023-12-12 changing shift register paths
    [dac_lds.sch, register_dac_mc_andrew.sch, register_dac_mc_andrew_lds.sch, register_lauren.sch]
2023-12-12 initial layout commit
    [register_dac_mc_andrew_lds.sch]
2023-12-12 adding plots for different clock frequencies
    [register_dac_single_andrew.sch]
2023-12-12 added second order filter and updated sim results
    [filter.sch]
2023-12-12 adding dac_unit layout, passes LVS
    [dac_unit_lds_v2.sch]
2023-12-12 making bias gen circuit external to dac
    [dac.sch, dac_lds.sch, register_dac_mc_andrew.sch, register_dac_mc_andrew_lds.sch, register_dac_single_andrew.sch, register_dac_tran_andrew.sch]
2023-12-13 making current generator external to bias gen circuit
    [register_dac_single_andrew.sch, v_gen_lds.sch]
2023-12-13 update simulation schematic
    [register_dac_mc_lauren.sch]
2023-12-14 changing dac layout, passes lvs
    [dac_lds_2.sch, register_dac_mc_andrew_lds.sch, register_dac_pres_andrew.sch, register_dac_tran_andrew.sch, v_gen_lds.sch]
2023-12-14 adding bias gen layout, passes lvs
    [v_gen_lds.sch]
2023-12-15 editted dac layout for higher level integration
    [dac_unit_lds2.sch]
2023-12-16 re-spec LPF RC values
    [cap.sch, dac.sch, filter.sch, filter_lvs.sch, final_lds.sch, register_dac_mc_lauren.sch, register_dac_tran_lauren.sch, res.sch]
2023-12-16 editted dac layout
    [dac.sch, register_dac_mc_lauren.sch]
2023-12-17 finalized layout
    [filter_lvs.sch, final_lds.sch]
2023-12-18 added not-working post layout simulations and organized files
    [cap.sch, cascode_v_gen.sch, dac.sch, dac_lds.sch, dac_lds_2.sch, dac_tran (copy).sch, dac_tran.sch, dac_unit_lds.sch]
2023-12-18 added some progress on post layout simulations
    [post_layout_tran.sch, postlayout_register.sch]
2023-12-18 added buffers to final layout
    [dac.sch, dac_unit_lds2.sch, final_lds.sch, post_layout_tran.sch, register_lauren.sch]
2023-12-18 added working post layout simulations
    [post_layout_tran.sch]
2023-12-18 updated screenshots of output filter and final layout
2023-12-19 push final changes to report and simulation files
    [cascode_v_gen.sch, filter.sch, filter_lvs.sch, final_lds.sch, post_layout_mc.sch, register_dac_mc_lauren.sch, register_dac_tran_lauren.sch, register_lauren.sch]
2024-01-05 cleaning old simulation files
    [register_dac_mc_andrew.sch, register_dac_mc_andrew_lds.sch, register_dac_mc_lauren.sch, register_dac_pres_andrew.sch, register_dac_tran_andrew.sch, register_dac_tran_lauren.sch]
2024-01-23 commit the final changes from December 2023, updated some plots
    [dac_tran.sch, post_layout_mc.sch, register_dac_tran_lauren.sch]
